Weritu/PET-Melter/README.md

# PET-Melter
Repositório criado parar armazenar arquivos importantes e referentes a montagem e desenvolvimento do TCC Manufatura Aditiva: O Upcycling de Garrafas PET.
