Weritu/PET-Melter/PCB/PET_Melter/PET_Melter.kicad_pcb

## KiCad design PCB/PET_Melter/PET_Melter.kicad_pcb (2025-12-09)

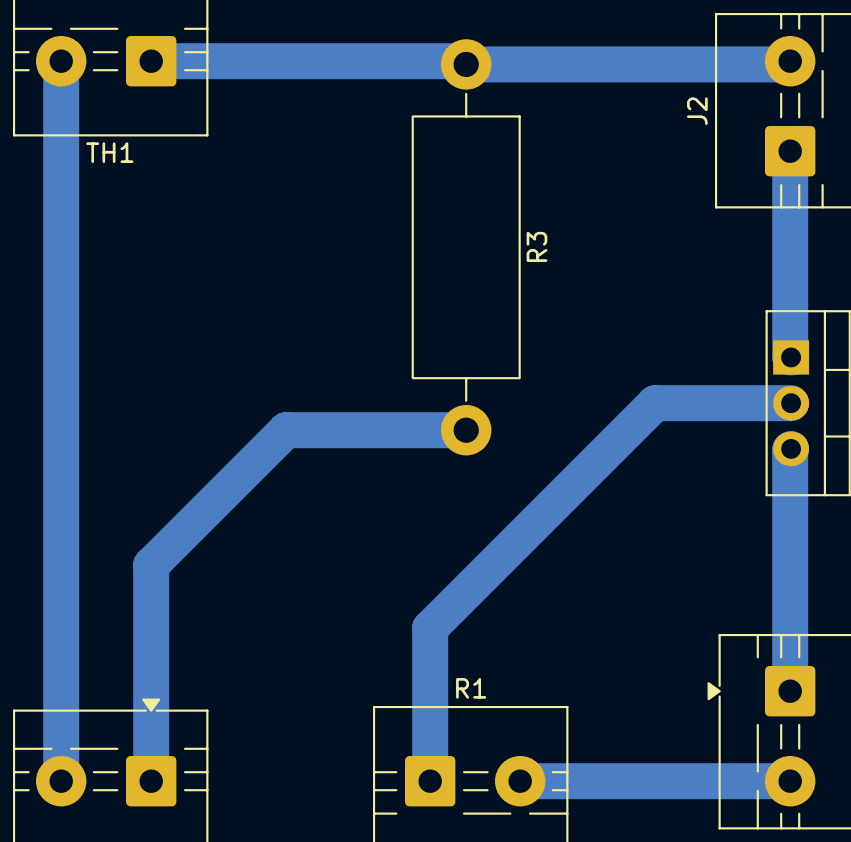
[picture p16: board PET_Melter.kicad_pcb from above]

Board: 2 copper layers, 7 parts (0 on the bottom side), 7 nets.

Parts:
J1: BorneAlimentação; TerminalBlock_MaiXu_MX126-5.0-02P_1x02_P5.00mm
J2: BorneArduino; TerminalBlock_MaiXu_MX126-5.0-02P_1x02_P5.00mm
J3: BorneAlimArduino; TerminalBlock_MaiXu_MX126-5.0-02P_1x02_P5.00mm
Q1: IRLZ44N; TO-220-3_Vertical
R1: Heater; TerminalBlock_MaiXu_MX126-5.0-02P_1x02_P5.00mm
R3: 100KΩ; R_Axial_DIN0614_L14.3mm_D5.7mm_P20.32mm_Horizontal
TH1: Thermistor; TerminalBlock_MaiXu_MX126-5.0-02P_1x02_P5.00mm

Connections:
+5V: J3.1, R3.2
A0: J2.2, R3.1, TH1.1
D6: J2.1, Q1.1 (G)
GND: J3.2, TH1.2
unnamed: J1.1, Q1.3 (S)
unnamed: J1.2, R1.2
unnamed: Q1.2 (D), R1.1
