Weritu/PET-Melter/(commit log)

2025-12-09 Código principal PETMelter
    Código fonte com a lógica para o funcionamento da máquina.
2025-12-09 PCB PETMelter.
    PCB com componentes referente a eletrônica do projeto.
    [PET_Melter.kicad_pcb, PET_Melter.kicad_sch]
